AndrejChoo/ZX_Keyboard_PS-2_on_CPLD/hardware/scheme/CPLD_Keyboard.png

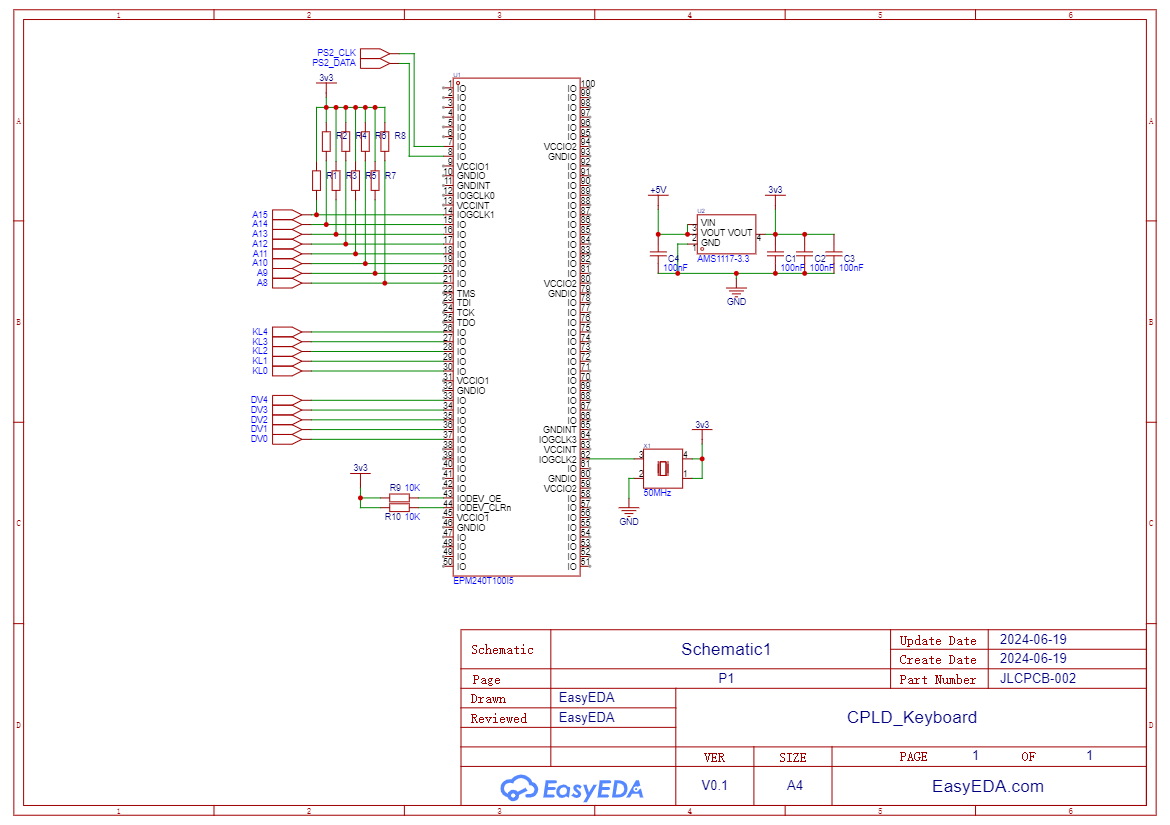
hardware/scheme/CPLD_Keyboard.png
