AndrejChoo/ZX_Keyboard_PS-2_on_CPLD/(list of files, drawings)

Other design files:
hardware/pcb/CPLD_Keyboard.lay6
